TSxx06/Projet-arduino/README.md

Notre projet s’appelle le « UPOS » , « useless piece of shit », c’est une boite avec des levier sur le dessus et un bras viendra appuyer sur le levier afin de le remettre dans sa position initiale,
il y aura un écran lcd afin de faire « parler » la boite et 7 leviers que le bras pourra repousser, un rail fera bouger le bras afin de s’aligner avec les leviers.
