TSxx06/Projet-arduino/Rapport de TD/Duffaud/1DUFFAUD.odt

RAPPORT DE SÉANCE 1 DUFFAUD

J’ai commencé la séance en récupérant tout le matériel dont j’avais besoin, une plaque blanche pour carte arduino, un banc d’interrupteur, des câbles, et des LED.

Au départ, le montage m’a pris du temps car je mettais une résistance par interrupteur ce qui prenais également beaucoup de place sur la carte, cependant, un prof m’a expliqué que sur le programme arduino on pour mettre « INPUT_PULLUP » ce qui permettait d’enlever la résistance pour que ce soit la carte qui la gère en la reliant directement avec le 5V, au départ j’avais pas bien compris comment monter ceci mais avec plusieurs essai j’ai réussi à tout faire marcher correctement.

J’ai également commencé le code afin d’obtenir la valeur de chaque interrupteur, ainsi que relier un bouton avec une LED en prévoyance de l’alimentation avec des piles de la carte arduino une fois dans a boîte.

Dans un second temps, j’ai appris à souder à l’aide d’un camarade car les interrupteur étaient tous soudés ensemble sur une plaque, j’ai donc commencé à dessouder (ce qui prend pas mal de temps car les anciens élèves qui avaient soudé les interrupteurs ont mis beaucoup d’étain) un interrupteur sur le 8 avant que l’heure sonne.

Finalement, je dirai que la séance a été moins productive que je l’espérais notamment à cause du montage des interrupteurs à déclarer en pullup e qui m’a pris énormément de temps.
