TSxx06/Projet-arduino/Rapport de TD/Duffaud/8DUFFAUD.pdf

Rapport de TP 8:

Lors de cette j’ai fini tous le réglages de branchement et organisé les câbles dans la boîte ainsi que les derniers détails du code arduino, notamment ceux sur la distance que devait parcourir le bras entre chaque interrupteurs. Nous avons avec Alexis rencontré un gros problème qui est que le servo moteur ne fournissait pas assez de force afin d’activer les interrupteurs donc c’était la catastrophe. A cours d’idée nous sommes aller demander de l’aide à des professeurs et avons trouvé une idée qui était d’imprimer des tubes à emboîter sur les interrupteurs avec de faire une sorte de levier, cependant le servo moteur ne pouvait toujours pas faire basculer l’interrupteur. Nous sommes donc arriver à court d’idées car en manque de temps nous ne pouvions pas nous permettre de changer ni les interrupteurs, ni le moteur faisant tourner le bras.

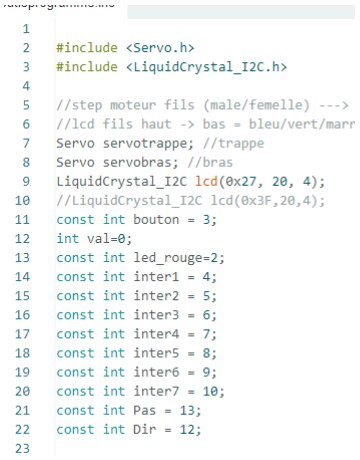
[picture p14: figure]
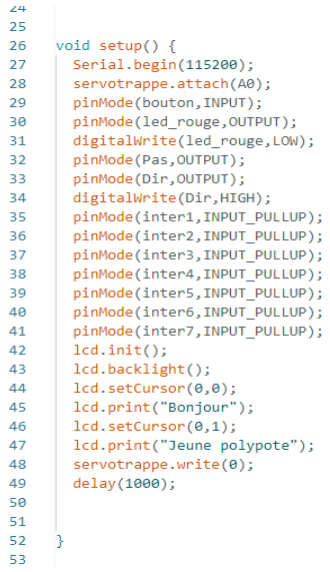
[picture p15: figure]
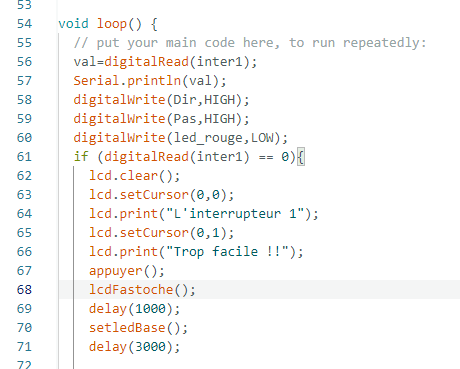
[picture p16: figure]
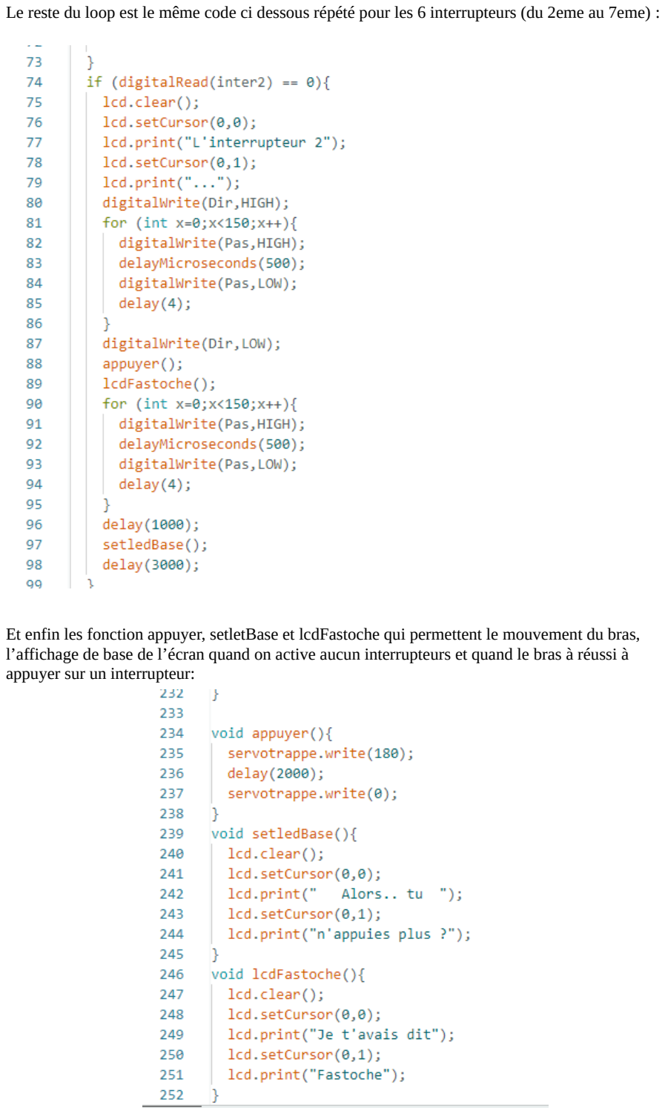
[picture p17: page 2]

Le reste du loop est le même code ci dessous répété pour les 6 interrupteurs (du 2eme au 7eme) :

Et enfin les fonction appuyer, setletBase et lcdFastoche qui permettent le mouvement du bras, l’affichage de base de l’écran quand on active aucun interrupteurs et quand le bras à réussi à appuyer sur un interrupteur:
