TSxx06/Projet-arduino/Rapport de TD/Duffaud/7DUFFAUD.pdf

Rapport de TP 7:

J’ai commencé la séance par régler un problème que j’avais avec le moteur pas à pas car lors de la dernière séance je n’arrivais plus à le faire tourner, je pensais au début que c’était un problème de branchement donc j’ai enlevé puis remit tous les câbles à leurs places pour être sur que si ça ne marcherait pas ce serait à cause du code, après avoir tout rebranché le moteur ne fonctionnait toujours pas donc j’ai utilisé le code exemple dans le cours de M.Masson afin de partir sur de bonnes bases. Après avoir régler ce problème de code tout fonctionnait parfaitement. Je me suis donc attaqué au code permettant de mouvoir la courroie de faire bouger le bras puis de faire revenir la courroie à la position de départ, voici donc le code quand j’appuie sur 1 des interrupteurs :

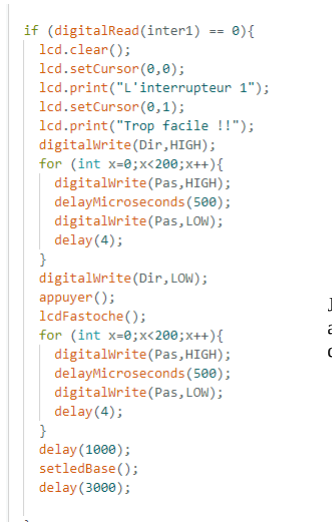
[picture p18: figure]
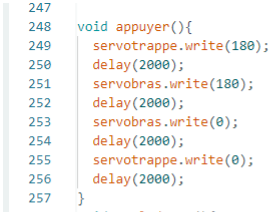
[picture p19: figure]

Je me suis ensuite attardé sur l’écran lcd et ce qu’il allait afficher en fonction de l’interrupteur activé en faisant les deux fonctions ci-dessous :

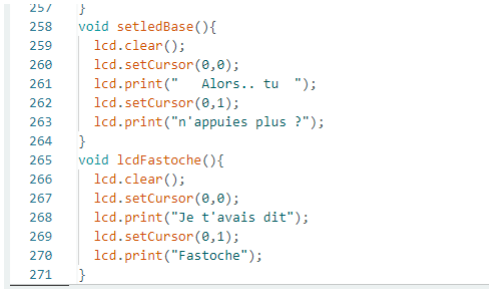
[picture p20: figure]

La fonction setledBase sert lors du démarrage de la carte arduino, c’est donc le premier message qui sera affiché sur l’écran, la fonction lcdFastoche sera la lorsque le bras réussira a appuyer sur l’interrupteur afin de le désactiver. J’ai dû enfin souder le bouton qui permettra à la carte arduino de s’allumer par le biais d’une batterie externe alimenté en 7V, j’ai dû aussi refaire quelques soudure au niveau des interrupteurs car d’une semaine à l’autre quelques fils s’étaient déssoudés.
