TSxx06/Projet-arduino/Rapport de TD/Duffaud/6DUFFAUD.pdf

Rapport de TP 6:

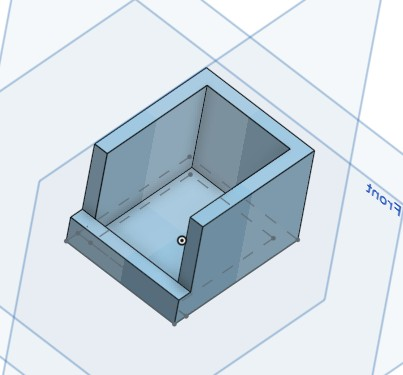
[picture p21: figure]
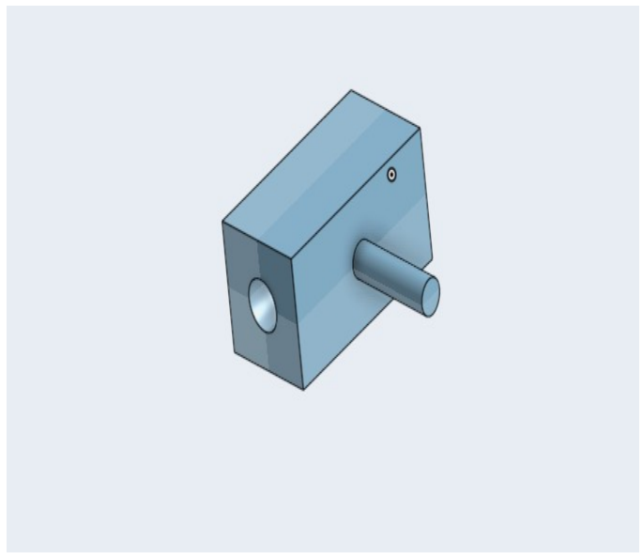
[picture p22: figure]

J’ai commencé la séance par la modélisation des deux pièces ci-dessus afin de les imprimer en 3D, la pièce de gauche sera le support pour le step moteur afin qu’il soit bien fixé pour ne pas qu’il fasse trembler toute la boîte, la seconde servira à tenir de l’autre coté de la boîte le roulement qui fera tourner la timing belt. Après la modélisation j’ai envoyé les pièce à mon binôme afin qu’il les envois sur l’imprimante 3D du fablab. Je me suis ensuite attardé sur la forme que le code prendra, surtout au niveau des 2 servos moteur et du step moteur.

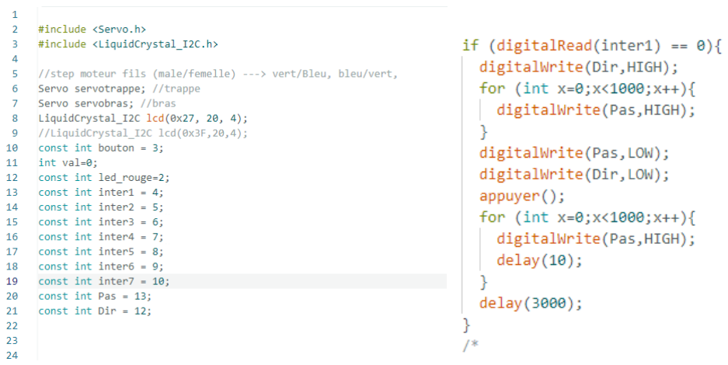
[picture p23: figure]

Ci-dessus vous pouvez voir l’initialisation des deux servos moteur, puis à droite une condition qui servira à actionner le bras quand un interrupteur sera actionné, il y a donc 7 parties de code comme ceci, une pour chaque interrupteur, on peut également voir dans le code la fonction « appuyer() » qui est la fonction qui servira à ouvrir la trappe puis bouger le
bras pour enfin refermer la trappe, voici la fonction.
J’ai décidé de faire une fonction car cela était plus pratique car
écrire ce code 7 fois aurait fait brouillon.

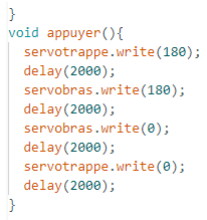
[picture p24: figure]

Pour finir la séance, je suis allé au fablab afin de limer la barre en métal que M.Masson nous avez donné à la dernière séance
