TSxx06/Projet-arduino/Rapport de TD/Duffaud/5DUFFAUD.pdf

Rapport de TP 5:

J’ai commencé la séance en m’attaquant au step moteur et à son branchement, après avoir tout branché je me suis rendu compte que je n’avais pas le moteur conforme au cours de M.Masson j’ai donc dû trouver un autre moteur, après l’avoir pris j’ai fais le branchement sur le driver A4988 avec une alimentation en 12V. Cependant après quelques minutes d’utilisation le moteur chauffait beaucoup trop j’ai donc fait des test avec le générateur de tension sur notre table, j’en suis arrivé au fait qu’utiliser une tension de 9V était la solution optimale afin que le moteur ne chauffe pas mais qu’il tourne quand même assez vite.

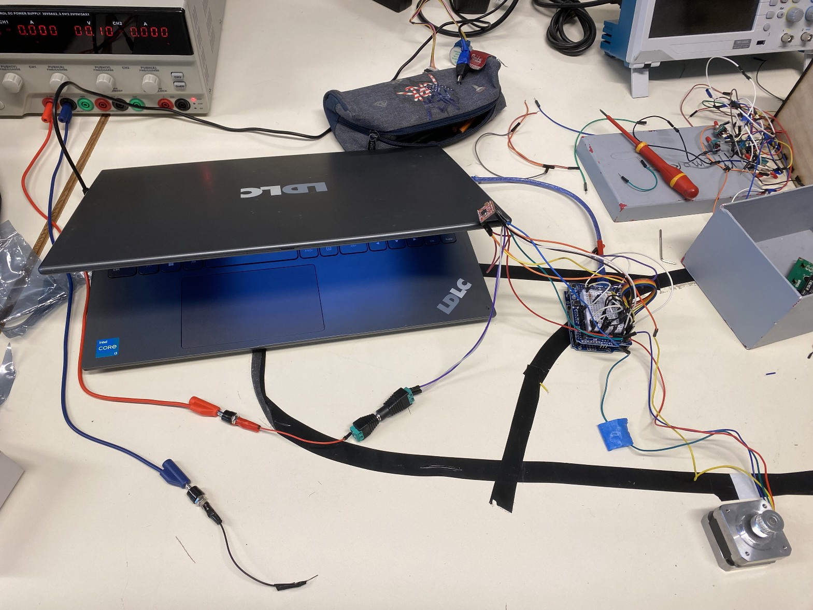
[picture p25: figure]

Pour vouloir faire tourner le moteur dans les deux sens j’ai demandé un pont en h à un professeur mais ensuite M.Rallo qui m’a expliqué en détail comment marchait un step moteur, je me suis rendu compte après que le driver A4988 faisait déjà le travail du pont en h et qu’il fallait juste changer un paramètre afin que le moteur tourne dans l’autre sens.

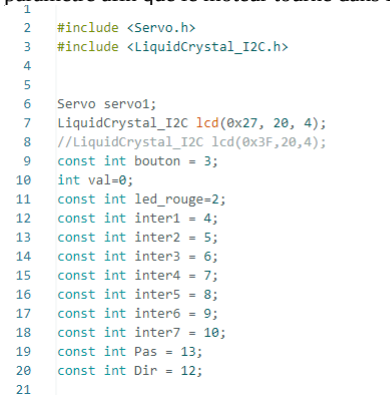
[picture p26: figure]
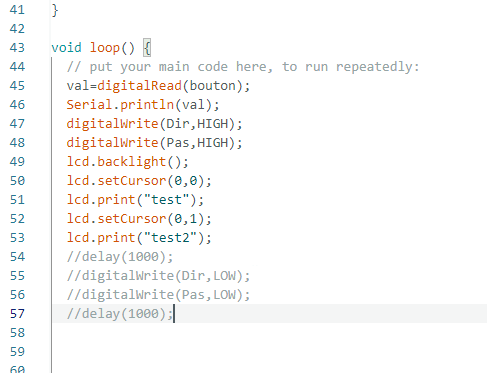
[picture p27: figure]

J’ai ensuite fait les codes respectifs du moteur et de l’écran lcd 16x2 que je n’avais jamais utilisé avant, j’ai dû importer la bibliothèque lcd i2c puis faire le branchement de l’écran qui était assez facile.
