TSxx06/Projet-arduino/Rapport de TD/Duffaud/2DUFFAUD.pdf

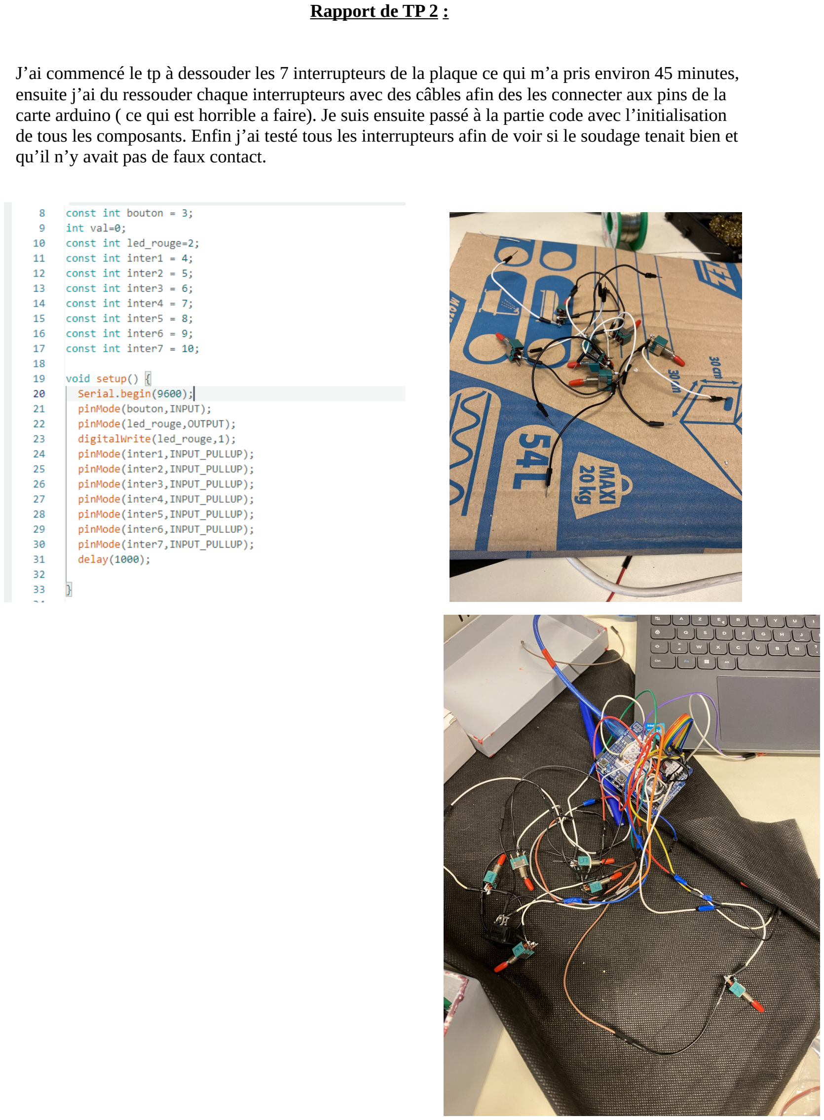
[picture p29: page 1]

Rapport de TP 2 :

J’ai commencé le tp à dessouder les 7 interrupteurs de la plaque ce qui m’a pris environ 45 minutes, ensuite j’ai du ressouder chaque interrupteurs avec des câbles afin des les connecter aux pins de la carte arduino ( ce qui est horrible a faire). Je suis ensuite passé à la partie code avec l’initialisation de tous les composants. Enfin j’ai testé tous les interrupteurs afin de voir si le soudage tenait bien et qu’il n’y avait pas de faux contact.
