TSxx06/Projet-arduino/Rapport de TD/Duffaud/4DUFFAUD.pdf

Rapport de TP 4 :

Avoir avoir étudié le branchement du step moteur que j’avais pris lors de la 3ème séance, je l’ai connecté à la carte arduino afin de tester sa vitesse de rotation, malheureusement après avoir passé un temps fou à coder le programme pour faire tourner le moteur et que ça marche, la vitesse du moteur était vraiment trop faible pour notre projet, je me suis donc réorienté vers un autre step moteur, le moteur NEMA17.

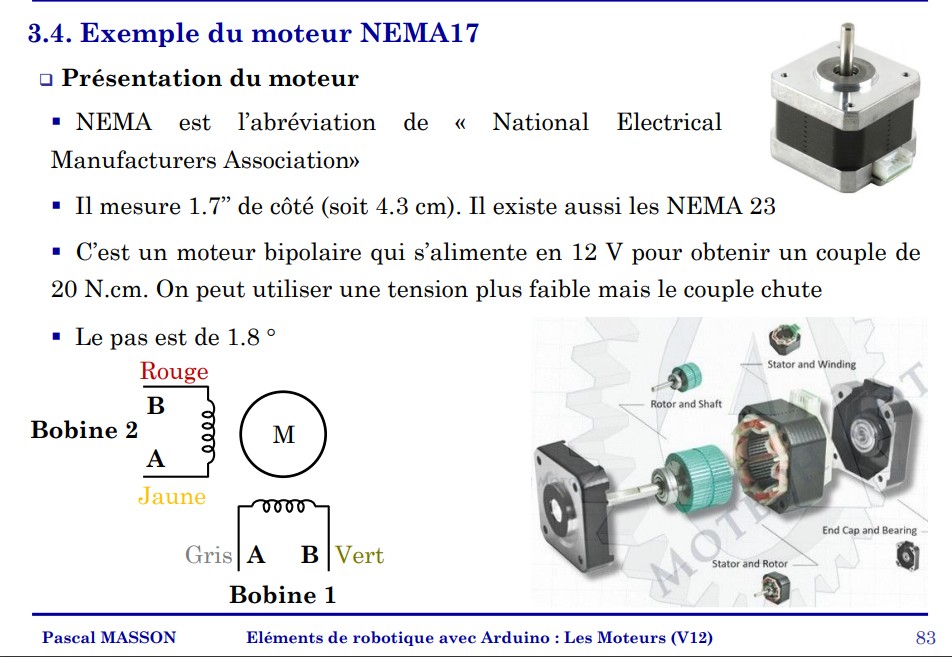
[picture p36: figure]
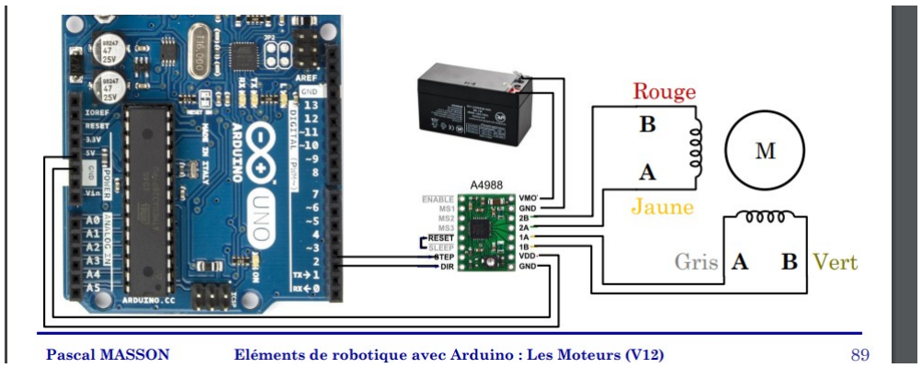
[picture p37: figure]

J’ai commencé à recopier le branchement de ce schéma que j’ai pas eu le temps et il n’y avait plus de câble femelle/femelle en stock. J’ai également travailler sur les servo-moteurs qui vont être utile afin d’ouvrir la trappe où passera le bras et celui qui va faire tourner le bras. Enfin on a passé avec Alexis l’oral de la 4ème séance sur notre projet.
