TSxx06/Projet-arduino/(commit log)

2023-12-15 Rapport de TD 1
2024-03-21 Rename Raport Arduino.pdf to Rapport Arduino.pdf
